kms15/ASTMF1862Tester/ControllerSchematic/ControllerSchematic.pdf

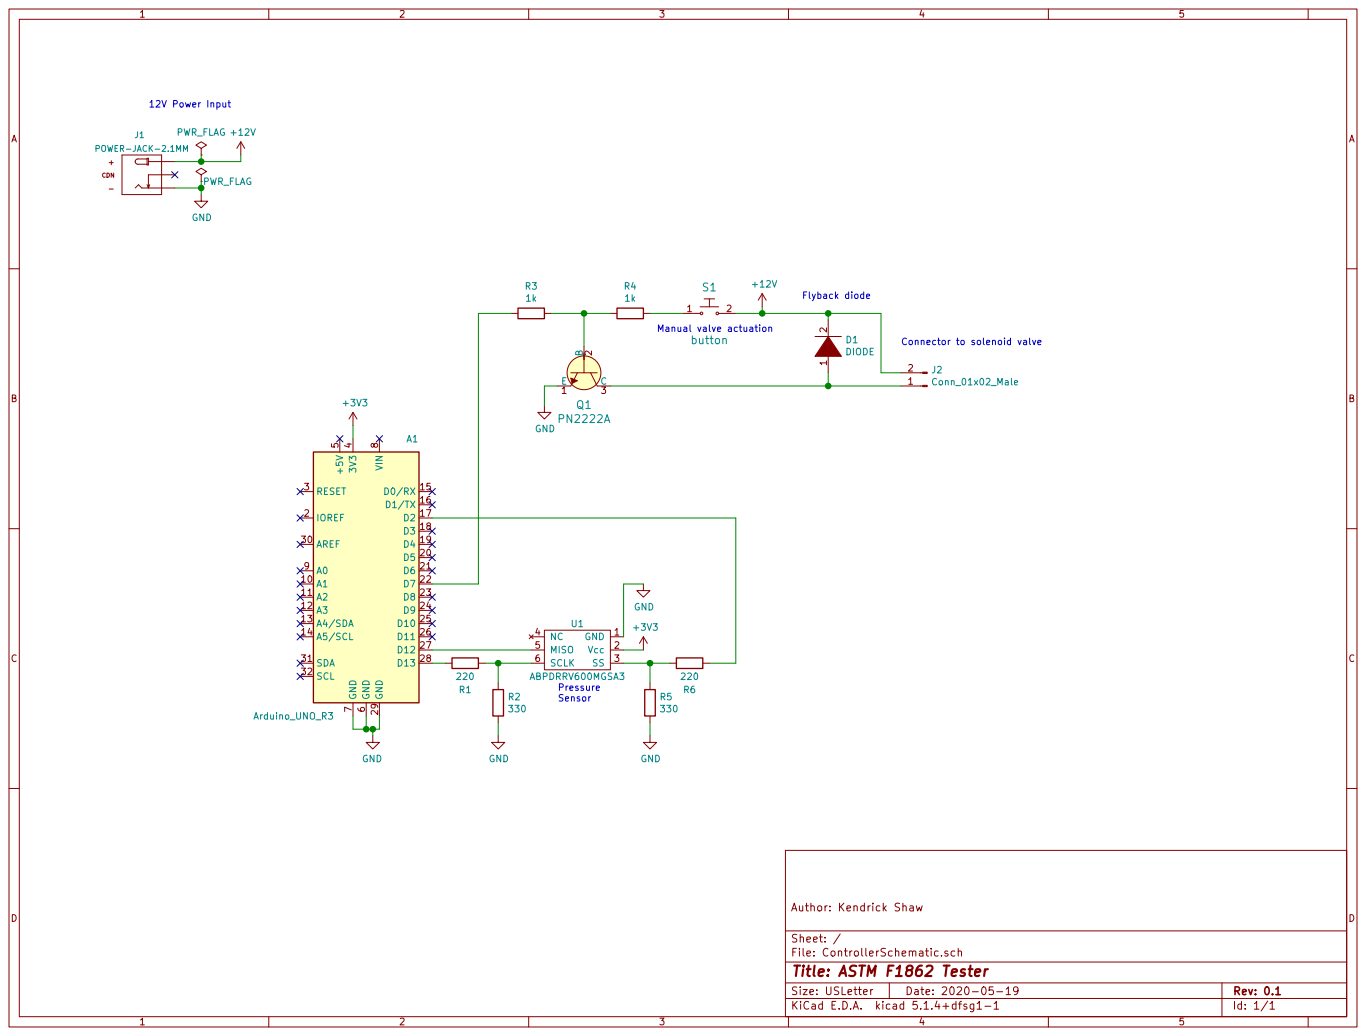
[picture p5: page 1]

Id: 1/1 Title: ASTM F1862 Tester File: ControllerSchematic.sch Sheet: / Author: Kendrick Shaw
