kms15/ASTMF1862Tester/ControllerSchematic/ControllerSchematic.sch

## KiCad design ControllerSchematic/ControllerSchematic.sch (2020-05-19)

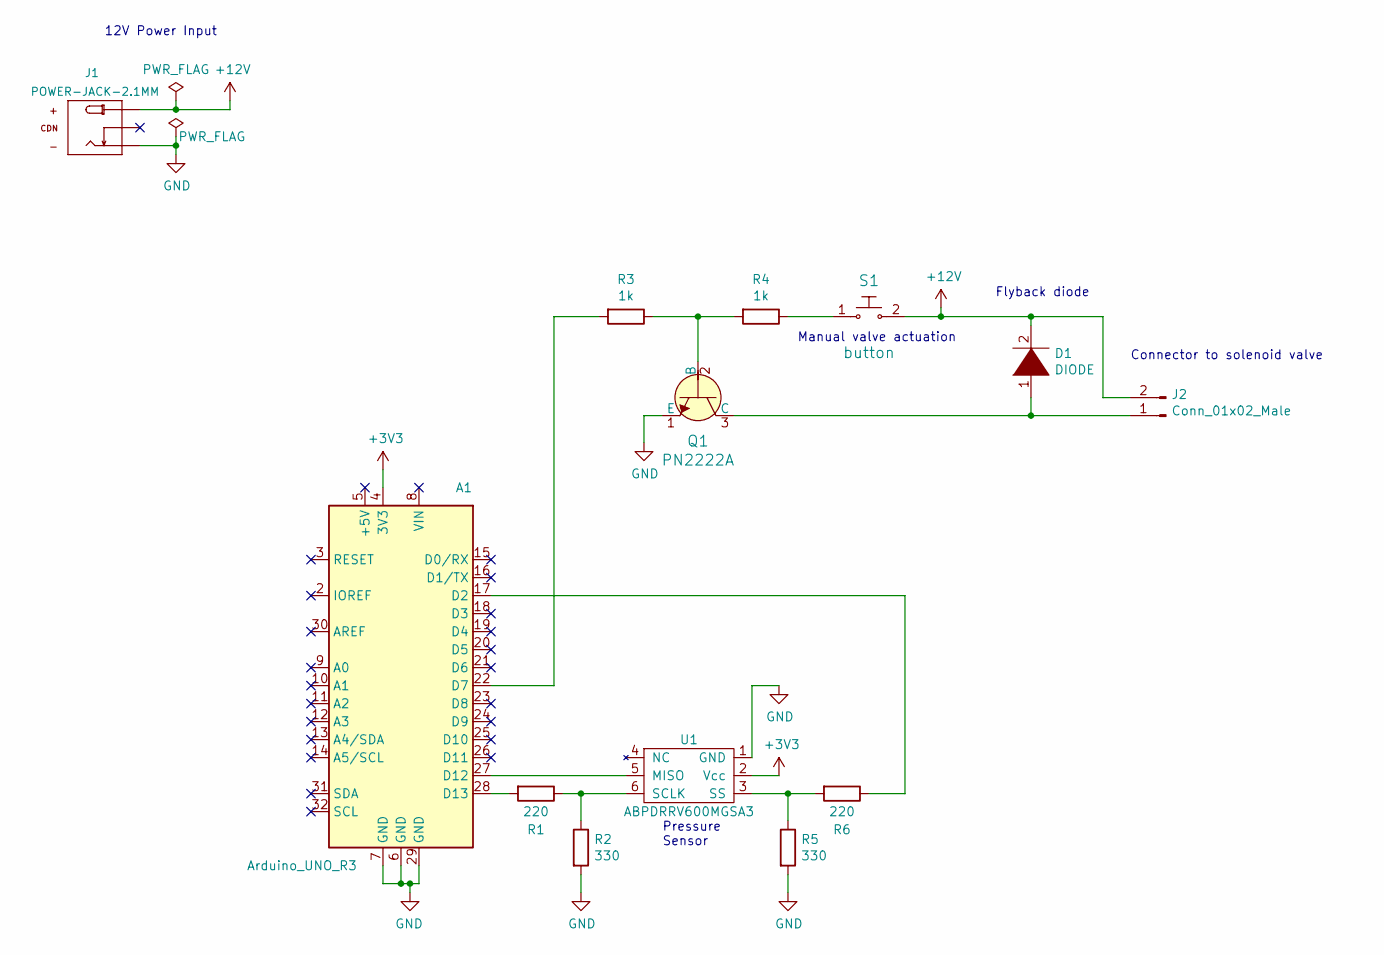
[picture p6: schematic ControllerSchematic.sch]

Parts:
A1: Arduino_UNO_R3
D1: DIODE
J1: POWER-JACK-2.1MM; MPN DC-005
J2: Conn_01x02_Male
Q1: PN2222A; TO-92-3; MPN PN2222A; Digi-Key_PN PN2222ACS-ND
R1, R6: 220
R2, R5: 330
R3, R4: 1k
S1: button; Switch_Tactile_SMD_B3U-1000P; MPN B3U-1000P; Digi-Key_PN SW1020CT-ND
U1: ABPDRRV600MGSA3

Connections:
+3V3: A1.4 (3V3), U1.2 (Vcc)
+12V: D1.2 (A), J1.1 (+), J2.2, S1.2
GND: A1.6 (GND), A1.7 (GND), A1.29 (GND), J1.2 (-), Q1.1 (E), R2.2, R5.2, U1.1 (GND)
unnamed: A1.17 (D2), R6.1
unnamed: A1.22 (D7), R3.2
unnamed: A1.27 (D12), U1.5 (MISO)
unnamed: A1.28 (D13), R1.2
unnamed: D1.1 (K), J2.1, Q1.3 (C)
unnamed: Q1.2 (B), R3.1, R4.2
unnamed: R1.1, R2.1, U1.6 (SCLK)
unnamed: R4.1, S1.1
unnamed: R5.1, R6.2, U1.3 (SS)

Notes on the sheet:
Pressure Sensor
12V Power Input
Connector to solenoid valve
Flyback diode
Manual valve actuation
